sharjeelmazhar/solar-monitor/web/src/assets/earth/day.webp

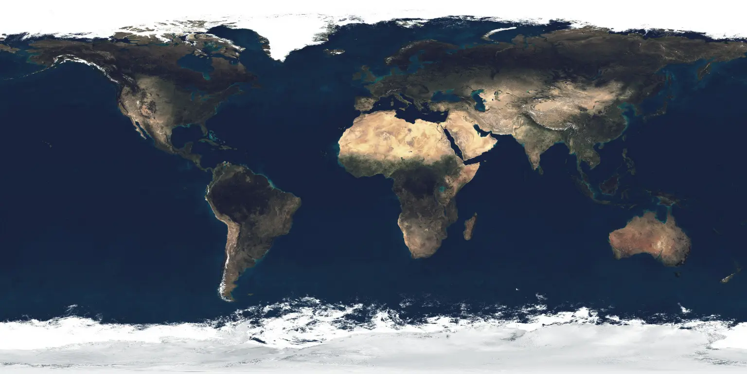
web/src/assets/earth/day.webp
