sharjeelmazhar/solar-monitor/web/src/assets/earth/night.webp

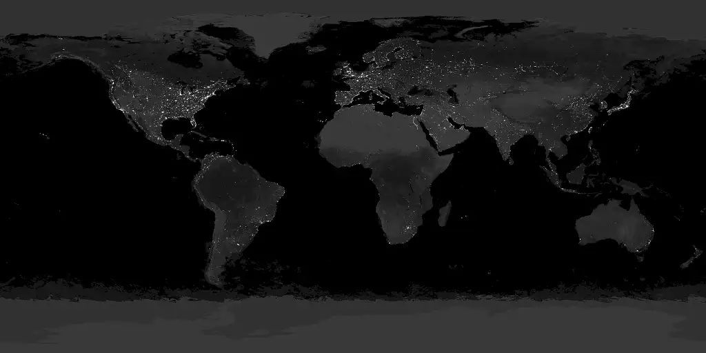
web/src/assets/earth/night.webp
