sharjeelmazhar/solar-monitor/docs/wiring/S3-wiring-page1.png

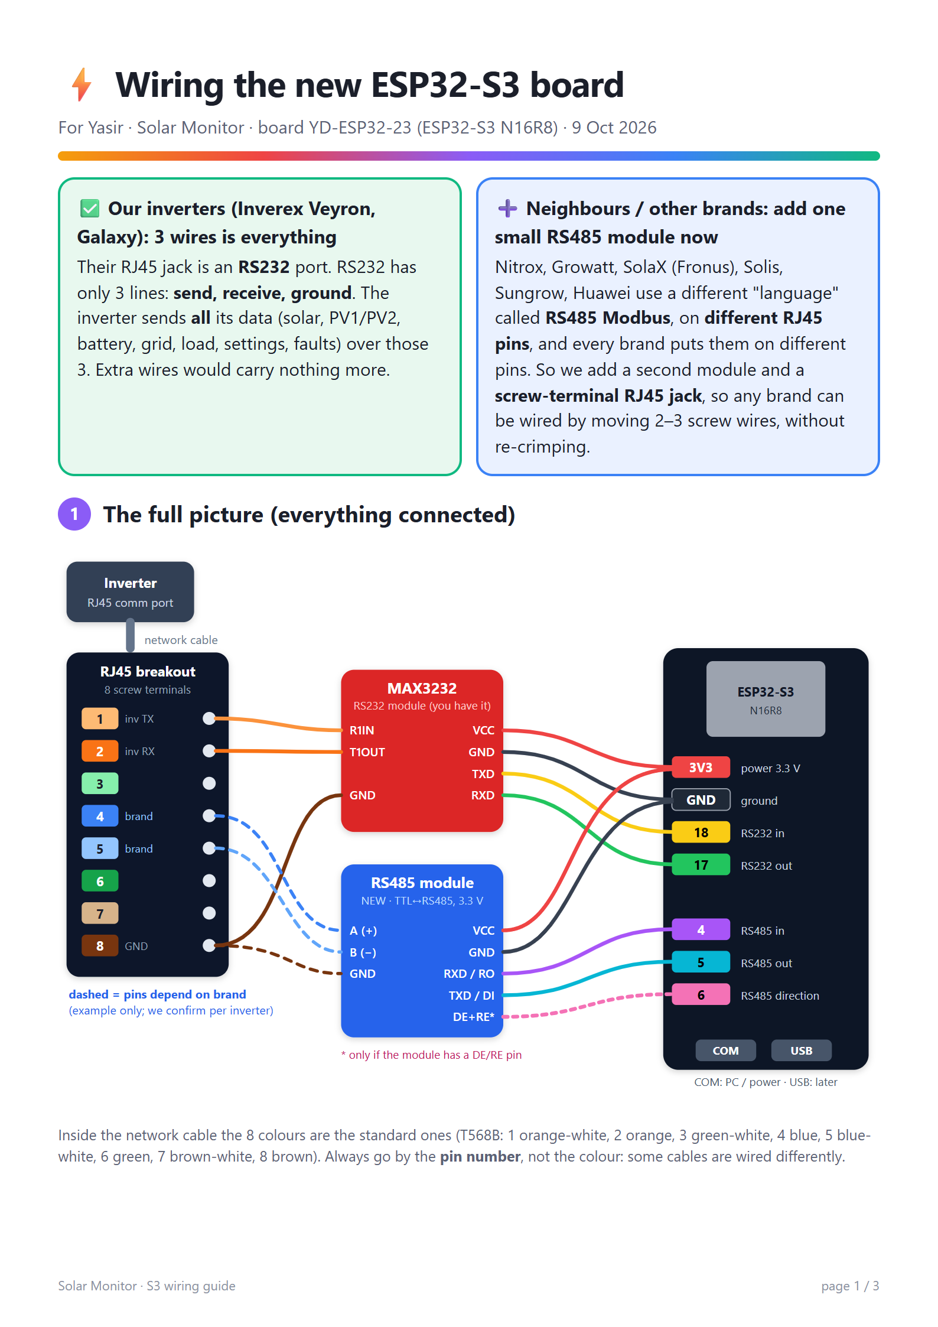
docs/wiring/S3-wiring-page1.png
