sharjeelmazhar/solar-monitor/docs/wiring/S3-wiring-page2.png

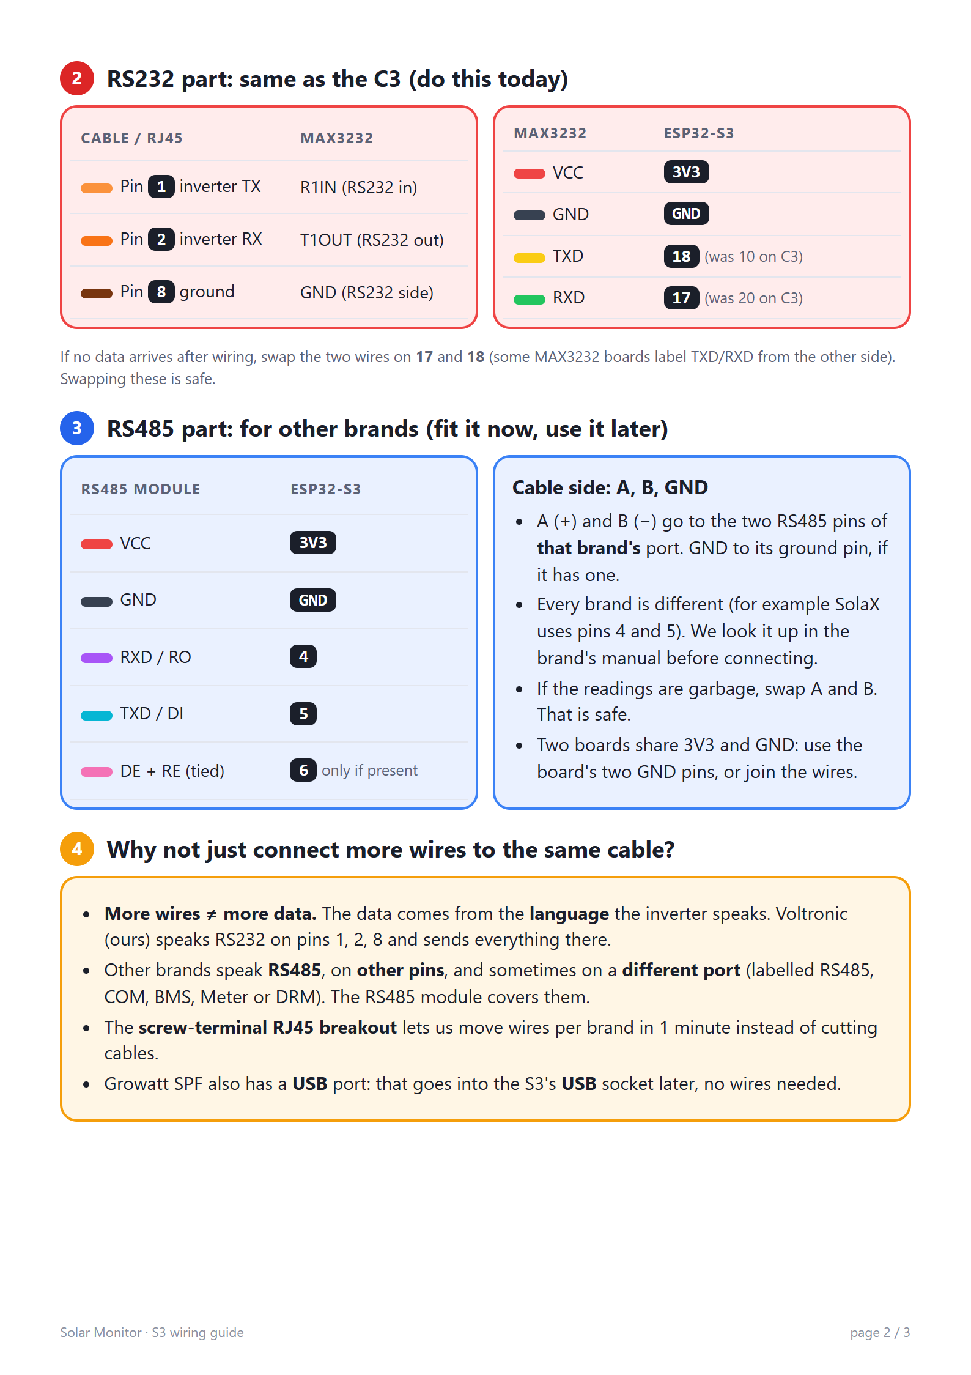
docs/wiring/S3-wiring-page2.png
