sharjeelmazhar/solar-monitor/docs/wiring/S3-wiring-page3.png

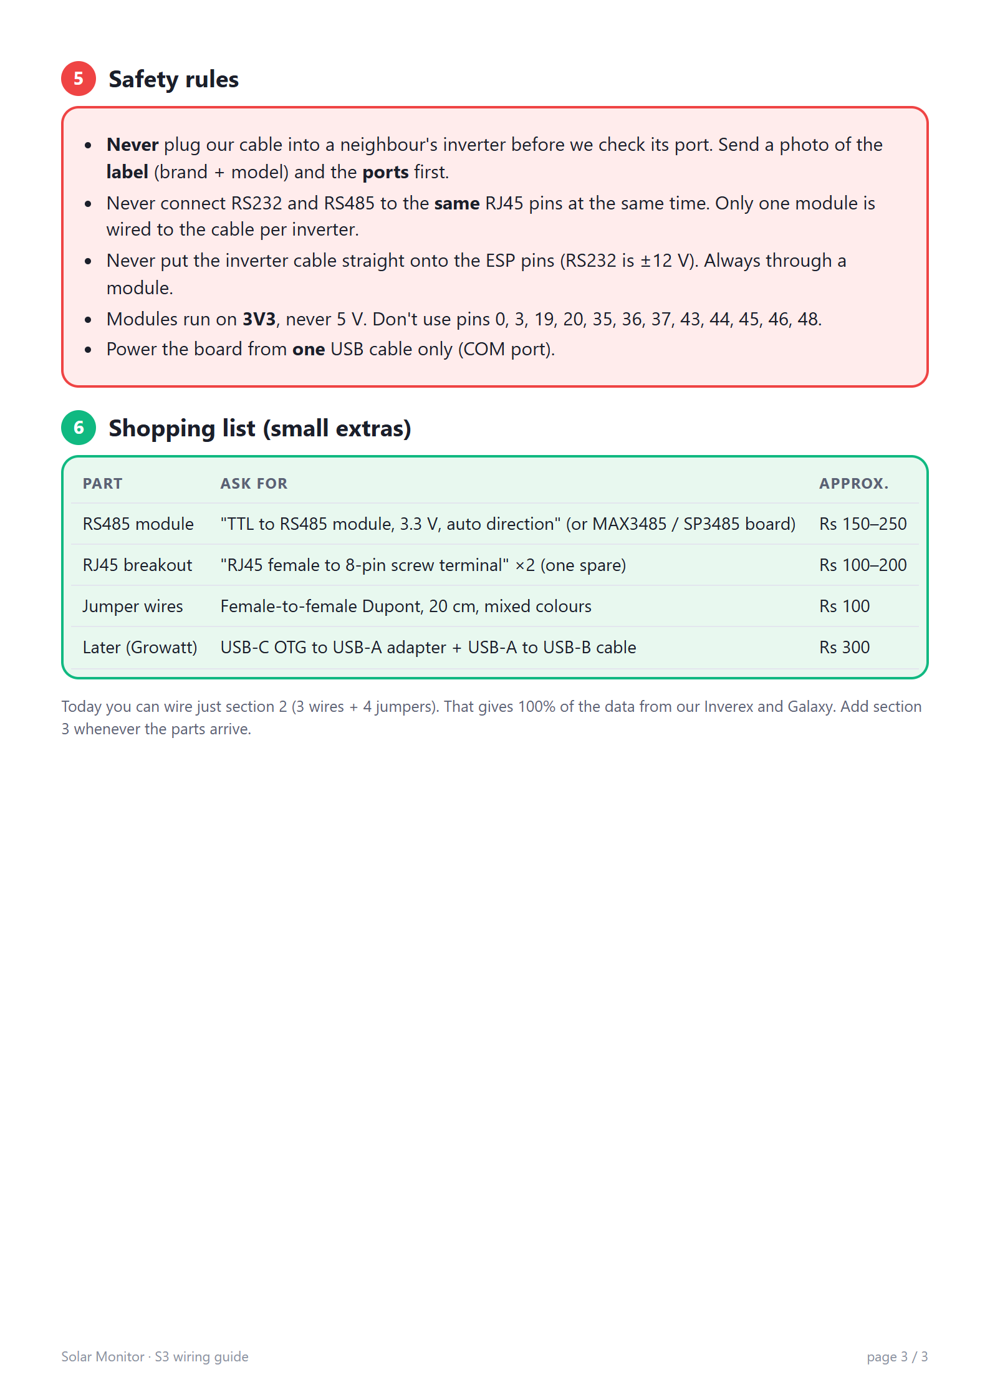
docs/wiring/S3-wiring-page3.png
