sharjeelmazhar/solar-monitor/firmware/solar_monitor_v3/solar_monitor_v3.ino

/*
  Solar Monitor v3 - ESP32-C3 Super Mini + MAX3232 + Inverex Veyron (Voltronic PI30 protocol)

  What it does
    - Reads the inverter as fast as the 2400-baud link allows (~1 reading per 0.7 s)
    - Pushes every change instantly to all open dashboards (Server-Sent Events, /events)
    - Keeps per-minute history on flash (~45 days) and daily energy totals (~2 years)
    - Syncs the clock from the internet (NTP); a dashboard can also set it if there is no internet
    - Serves the dashboard itself: http://<ESP32-IP>/ or http://solar.local/
    - Firmware can be updated over Wi-Fi: http://solar.local/update  (user admin, password in config.h)

  Wiring:
    MAX3232 VCC -> 3V3, GND -> GND, TXD -> GPIO10, RXD -> GPIO20
    MAX3232 RS232 side -> inverter RJ45: pin1 = TX, pin2 = RX, pin8 = GND

  Arduino IDE: Board "ESP32C3 Dev Module", USB CDC On Boot = Enabled,
               Partition Scheme = Default 4MB with spiffs.
  Libraries:   "ESP Async WebServer" and "Async TCP" (both by ESP32Async), from Library Manager.
  The web page lives in web/index.html; run build_web.ps1 to regenerate web_index.h after editing it.

  HTTP API (all JSON unless noted, CORS open so apps can use it)
    GET  /events                 SSE stream, event "live" = same JSON as /api/live, on every change
    GET  /events/status          same, but only on mode/grid/battery%/warning changes + 60 s heartbeat (for phones in background)
    GET  /api/live               latest reading + today's totals
    GET  /api/info               device, Wi-Fi, storage, inverter ratings (raw QPIRI etc.), settings
    GET  /api/recent             binary Sample[] (16 B each), last ~15 min, oldest first
    GET  /api/day?d=YYYYMMDD     binary MinRec[] (24 B each) for that local day
    GET  /api/days               binary DayRec[] (40 B each), oldest first, today (in progress) last
    POST /api/time    t=<epoch seconds>                      set clock if NTP is not available
    POST /api/settings battAh, tariff, name, tz              user settings
    GET/POST /api/bill  v=<json, max 2 KB>                    bill estimator settings (opaque to the firmware)
    POST /api/wifi    ssid, pass          (admin auth)       join another network
    GET  /api/scan                                            nearby Wi-Fi networks
    POST /api/refresh                                         re-read inverter ratings now
    GET/POST /update                      (admin auth)       firmware update
*/

#include <WiFi.h>
#include <ESPmDNS.h>
#include <LittleFS.h>
#include <Preferences.h>
#include <Update.h>
#include <esp_wifi.h>
#include <esp_task_wdt.h>
#include <esp_ota_ops.h>
#include <DNSServer.h>
#include <sys/time.h>
#include <AsyncTCP.h>
#include <ESPAsyncWebServer.h>
#include "config.h"
#include "inverter.h"
#include "invset.h"
#include "history.h"
#include "web_index.h"
#include "setup_page.h"

AsyncWebServer server(80);
DNSServer dns;   // setup hotspot: answers every name with our address so phones open the setup page
AsyncEventSource events("/events");
AsyncEventSource statusEvents("/events/status");   // quiet stream for phone background alerts
Preferences prefs;
SemaphoreHandle_t dataMux;

// ---------- shared state (guarded by dataMux) ----------
Live live;
bool everOk = false;
uint32_t lastOkMs = 0, seq = 0, cycleMs = 0, okCount = 0, failCount = 0;
char liveJson[1600] = "{\"ok\":false,\"ever\":false}";

Sample ring[RECENT_SAMPLES];
int ringHead = 0, ringCount = 0;   // head = next write position

MinRec todayRecs[1440];
int todayCount = 0;

DayRec today;            // running totals for the current local day
bool todayLoaded = false;
uint32_t histFrom = 0;   // oldest day with minute data

// inverter info, refreshed rarely
char qpiri[160] = "", qid[40] = "", qvfw[40] = "", qflag[40] = "";
char chgCur[64] = "", acCur[64] = "";   // allowed max charge currents (QMCHGCR / QMUCHGCR)
char qbeqi[64] = "";                    // battery equalization settings (QBEQI)

// a settings change waiting for the loop task: state 0 none, 1 waiting, 2 done ok, 3 failed
struct SetJob {
  uint32_t id = 0;
  uint8_t state = 0;
  char key[16] = "";
  float value = 0;
  char letter = 0;
  char by[40] = "";
  char msg[96] = "";
} setJob;
uint8_t probeState = 0;   // 0 never, 1 waiting, 2 done
String probeText;

// settings
float setBattAh = 0, setTariff = 0;
String setName = "Solar", setTz = TZ_DEFAULT;
String setBill;   // bill estimator settings: JSON written by the apps, stored as-is

// Billing month counter: energy since the last meter reading (reading day + hour, sent by the apps from the bill
// settings). Kept in NVS so a restart doesn't lose it; at most 15 minutes of counting are lost on a power cut.
int setCycDay = 0, setCycHour = 20;   // day 0 = not set yet
struct Cycle {
  uint32_t start = 0;      // epoch of the meter reading this month started at
  uint32_t from = 0;       // when counting began (later than start if the monitor was off or set up mid-month)
  float gridWh = 0, loadWh = 0, pvWh = 0;
  uint32_t onMin = 0;      // minutes the monitor was reading the inverter this month
  uint32_t prevStart = 0;  // the month before (so the apps can show the last bill's measured units)
  float prevGridWh = 0;
  uint32_t prevOnMin = 0;
} cyc;
uint32_t cycSavedMs = 0;
volatile bool cycMoved = false;   // reading day/hour changed in the settings

// misc
bool fsOk = false, mdnsOk = false, apOn = false, rebootPending = false, refreshRated = true;
bool timeSetByClient = false;
uint32_t wifiLostAt = 0, rebootAt = 0, staUpAt = 0, joinAt = 0;
char apName[24] = SETUP_AP_SSID;

// ---------- minute accumulator (loop task only) ----------
struct {
  uint32_t minute = 0;   // epoch / 60
  uint32_t n = 0;
  double pv = 0, load = 0, grid = 0, batt = 0, battV = 0, pvV = 0, gridV = 0, outV = 0;
  uint8_t battPct = 0, mode = '?', flags = 0;
  int8_t tempMax = -128;
} acc;

static void ledSet(bool on) {
  if (LED_PIN >= 0) digitalWrite(LED_PIN, on ? LED_ON : !LED_ON);
}

// A new firmware starts "on trial": if it can't get back on Wi-Fi within 5 minutes the board restarts and
// the bootloader goes back to the previous firmware by itself. Once it is on Wi-Fi it is kept.
extern "C" bool verifyRollbackLater() { return true; }
static void serviceTrial() {
  static bool done = false;
  if (done) return;
  const esp_partition_t* run = esp_ota_get_running_partition();
  esp_ota_img_states_t st;
  if (esp_ota_get_state_partition(run, &st) != ESP_OK || st != ESP_OTA_IMG_PENDING_VERIFY) { done = true; return; }
  if (WiFi.status() == WL_CONNECTED && millis() > 20000) {
    esp_ota_mark_app_valid_cancel_rollback();
    Serial.println("Firmware confirmed");
    done = true;
  } else if (millis() > 300000) {
    Serial.println("New firmware never reached Wi-Fi: going back to the previous one");
    esp_ota_mark_app_invalid_rollback_and_reboot();
  }
}

static bool timeValid() { return time(nullptr) > 1735689600; }   // after 2025-01-01

static inline void lock()   { xSemaphoreTake(dataMux, portMAX_DELAY); }
static inline void unlock() { xSemaphoreGive(dataMux); }

// only safe characters reach the JSON
static void jsonSafe(char* dst, const char* src, size_t cap) {
  size_t j = 0;
  for (size_t i = 0; src[i] && j < cap - 1; i++) {
    char c = src[i];
    if (c >= 32 && c < 127 && c != '"' && c != '\\') dst[j++] = c;
  }
  dst[j] = 0;
}

static uint8_t liveFlags(const Live& L) {
  uint8_t f = 0;
  if (L.gridOn) f |= 1;
  if (strlen(L.st) == 8) {
    if (L.st[6] == '1') f |= 2;   // b1 SCC (solar) charging
    if (L.st[7] == '1') f |= 4;   // b0 AC (grid) charging
    if (L.st[3] == '1') f |= 8;   // b4 load on
  }
  return f;
}

// ---------- JSON ----------
static void buildLiveJsonLocked() {
  const Live& L = live;
  struct timeval tv;
  gettimeofday(&tv, nullptr);
  double tms = timeValid() ? (double)tv.tv_sec * 1000.0 + tv.tv_usec / 1000 : 0;
  bool fresh = everOk && millis() - lastOkMs < STALE_MS;
  char err[64];
  jsonSafe(err, invErr, sizeof(err));
  char mode[2] = {L.mode ? L.mode : '?', 0};
  snprintf(liveJson, sizeof(liveJson),
    "{\"seq\":%lu,\"t\":%.0f,\"ok\":%s,\"ever\":%s,\"age\":%lu,\"mode\":\"%s\","
    "\"pvW\":%d,\"pvV\":%.1f,\"pvA\":%.1f,\"pv2V\":%.1f,\"pv2A\":%.1f,\"pvChgW\":%d,"
    "\"battV\":%.2f,\"battVscc\":%.2f,\"battPct\":%d,\"chgA\":%.1f,\"dischgA\":%.1f,\"battW\":%d,"
    "\"loadW\":%d,\"loadVA\":%d,\"loadPct\":%d,\"outV\":%.1f,\"outHz\":%.1f,"
    "\"gridOn\":%s,\"gridV\":%.1f,\"gridHz\":%.1f,\"gridW\":%d,"
    "\"tempC\":%d,\"busV\":%d,\"st\":\"%s\",\"st2\":\"%s\",\"warn\":\"%s\","
    "\"today\":{\"date\":%lu,\"pv\":%.1f,\"load\":%.1f,\"grid\":%.1f,\"chg\":%.1f,\"dis\":%.1f,"
    "\"gridOnMin\":%u,\"onlineMin\":%u,\"outages\":%u,\"pvPeak\":%u,\"loadPeak\":%u},"
    "\"poll\":{\"ms\":%lu,\"ok\":%lu,\"fail\":%lu,\"crc\":%lu,\"err\":\"%s\"},\"timeOk\":%s,"
    "\"cyc\":{\"s\":%lu,\"f\":%lu,\"g\":%.1f,\"l\":%.1f,\"p\":%.1f,\"m\":%lu,\"ps\":%lu,\"pg\":%.1f,\"pm\":%lu}}",
    (unsigned long)seq, tms, fresh ? "true" : "false", everOk ? "true" : "false",
    everOk ? (unsigned long)(millis() - lastOkMs) : 0UL, mode,
    L.pvW, L.pvV, L.pvA, L.pv2V, L.pv2A, L.pvChgW,
    L.battV, L.battVscc, L.battPct, L.chgA, L.dischgA, L.battW,
    L.outW, L.outVA, L.loadPct, L.outV, L.outHz,
    L.gridOn ? "true" : "false", L.gridV, L.gridHz, L.gridW,
    L.tempC, L.busV, L.st, L.st2, L.warn,
    (unsigned long)today.date, today.pvWh, today.loadWh, today.gridWh, today.chgWh, today.disWh,
    today.gridOnMin, today.onlineMin, today.outages, today.pvPeakW, today.loadPeakW,
    (unsigned long)cycleMs, (unsigned long)okCount, (unsigned long)failCount, (unsigned long)invCrcErrors, err,
    timeValid() ? "true" : "false",
    (unsigned long)cyc.start, (unsigned long)cyc.from, cyc.gridWh, cyc.loadWh, cyc.pvWh, (unsigned long)cyc.onMin,
    (unsigned long)cyc.prevStart, cyc.prevGridWh, (unsigned long)cyc.prevOnMin);
}

static String buildInfoJson() {
  char a[160], b[40], c[40], d[40], name[40], tz[40], ssid[40], m1[64], m2[64], eq[64];
  lock();
  jsonSafe(a, qpiri, sizeof(a)); jsonSafe(b, qid, sizeof(b));
  jsonSafe(c, qvfw, sizeof(c));  jsonSafe(d, qflag, sizeof(d));
  jsonSafe(m1, chgCur, sizeof(m1)); jsonSafe(m2, acCur, sizeof(m2)); jsonSafe(eq, qbeqi, sizeof(eq));
  jsonSafe(name, setName.c_str(), sizeof(name)); jsonSafe(tz, setTz.c_str(), sizeof(tz));
  uint32_t from = histFrom;
  unlock();
  jsonSafe(ssid, WiFi.SSID().c_str(), sizeof(ssid));
  char buf[1400];
  snprintf(buf, sizeof(buf),
    "{\"fw\":\"%s\",\"board\":\"" FW_BOARD "\",\"histVer\":%d,\"name\":\"%s\",\"host\":\"%s\",\"ip\":\"%s\",\"mac\":\"%s\",\"ssid\":\"%s\",\"rssi\":%d,"
    "\"ap\":%s,\"uptime\":%lu,\"heap\":%lu,\"minHeap\":%lu,\"fsUsed\":%lu,\"fsTotal\":%lu,\"fsOk\":%s,"
    "\"timeOk\":%s,\"time\":%lu,\"tz\":\"%s\",\"clients\":%u,\"histFrom\":%lu,"
    "\"battAh\":%.1f,\"tariff\":%.2f,\"cycDay\":%d,\"cycHour\":%d,\"reset\":%d,"
    "\"inv\":{\"proto\":\"%s\",\"qpiri\":\"%s\",\"qid\":\"%s\",\"qvfw\":\"%s\",\"qflag\":\"%s\",\"chgCur\":\"%s\",\"acCur\":\"%s\",\"beqi\":\"%s\"}}",
    FW_VERSION, HIST_VERSION, name, HOSTNAME, WiFi.localIP().toString().c_str(), WiFi.macAddress().c_str(), ssid,
    WiFi.RSSI(), apOn ? "true" : "false", (unsigned long)(millis() / 1000), (unsigned long)ESP.getFreeHeap(),
    (unsigned long)ESP.getMinFreeHeap(), fsOk ? (unsigned long)LittleFS.usedBytes() : 0UL,
    fsOk ? (unsigned long)LittleFS.totalBytes() : 0UL, fsOk ? "true" : "false",
    timeValid() ? "true" : "false", (unsigned long)time(nullptr), tz, (unsigned)events.count(), (unsigned long)from,
    setBattAh, setTariff, setCycDay, setCycHour, (int)esp_reset_reason(), protoName(invProto), a, b, c, d, m1, m2, eq);
  return String(buf);
}

// ---------- history ----------
static void finalizeMinute() {
  if (acc.n == 0 || !fsOk) { acc.n = 0; return; }
  MinRec m;
  m.t = acc.minute * 60;
  m.pvW = (uint16_t)lround(acc.pv / acc.n);
  m.loadW = (uint16_t)lround(acc.load / acc.n);
  m.gridW = (uint16_t)lround(acc.grid / acc.n);
  m.battW = (int16_t)lround(acc.batt / acc.n);
  m.battV = (uint16_t)lround(acc.battV / acc.n * 100);
  m.pvV = (uint16_t)lround(acc.pvV / acc.n * 10);
  m.gridV = (uint16_t)lround(acc.gridV / acc.n * 10);
  m.outV = (uint16_t)lround(acc.outV / acc.n * 10);
  m.battPct = acc.battPct;
  m.tempC = acc.tempMax;
  m.mode = acc.mode;
  m.flags = acc.flags;
  acc.n = 0;
  acc.pv = acc.load = acc.grid = acc.batt = acc.battV = acc.pvV = acc.gridV = acc.outV = 0;
  acc.tempMax = -128;

  uint32_t date = localDate(m.t);
  if (date != today.date) return;   // belongs to a day we already closed
  lock();
  bool dup = todayCount > 0 && todayRecs[todayCount - 1].t >= m.t;
  if (!dup && cyc.start && m.t >= cyc.start) cyc.onMin++;
  if (!dup && todayCount < 1440) {
    todayRecs[todayCount++] = m;
    today.onlineMin++;
    if (m.flags & 1) today.gridOnMin++;
  }
  unlock();
  if (dup) return;
  if (!LittleFS.exists("/h")) LittleFS.mkdir("/h");
  File f = LittleFS.open(dayPath(date), "a");
  if (f) { f.write((const uint8_t*)&m, sizeof(m)); f.close(); }
}

// Called once the clock is valid: restore today's minutes and totals from flash.
static void loadToday() {
  uint32_t date = localDate(time(nullptr));
  DayRec d;
  dayInit(d, date);
  int cnt = 0;
  if (fsOk) reconcileAndPrune(date);
  lock();
  if (fsOk) {
    File f = LittleFS.open(dayPath(date), "r");
    if (f) {
      bool pk = false, pg = false;
      MinRec m;
      while (cnt < 1440 && f.read((uint8_t*)&m, sizeof(m)) == sizeof(m)) {
        if (cnt && m.t <= todayRecs[cnt - 1].t) continue;
        todayRecs[cnt++] = m;
        dayAddMinute(d, m, pk, pg);
      }
      f.close();
    }
  }
  if (cnt == 0) d.battMin = 255;
  todayCount = cnt;
  // keep energy counted before the clock was set
  d.pvWh += today.pvWh; d.loadWh += today.loadWh; d.gridWh += today.gridWh;
  d.chgWh += today.chgWh; d.disWh += today.disWh;
  today = d;
  histFrom = fsOk ? oldestDayFile() : 0;
  todayLoaded = true;
  unlock();
  Serial.printf("History: today %lu, %d minutes restored, history from %lu\n", (unsigned long)date, cnt, (unsigned long)histFrom);
}

static void rollDay(uint32_t newDate) {
  finalizeMinute();
  DayRec done;
  lock();
  done = today;
  if (done.onlineMin == 0 && done.battMin == 255) done.battMin = 0;
  dayInit(today, newDate);
  todayCount = 0;
  unlock();
  if (fsOk) {
    appendDay(done);
    reconcileAndPrune(newDate);
    uint32_t from = oldestDayFile();
    lock(); histFrom = from; unlock();
  }
  Serial.printf("New day %lu\n", (unsigned long)newDate);
}

// ---------- billing month ----------
// The last meter reading at or before `now`: day setCycDay of this month (or the month before) at setCycHour, local time.
static time_t cycleStartFor(time_t now) {
  struct tm t;
  localtime_r(&now, &t);
  for (int back = 0; back < 2; back++) {
    struct tm c = t;
    c.tm_mon -= back;
    c.tm_mday = setCycDay; c.tm_hour = setCycHour; c.tm_min = 0; c.tm_sec = 0; c.tm_isdst = -1;
    time_t s = mktime(&c);
    if (s <= now) return s;
  }
  return 0;
}

static void saveCycle() {
  Cycle c;
  lock(); c = cyc; unlock();
  prefs.putBytes("cyc", &c, sizeof(c));
  cycSavedMs = millis();
}

static void serviceCycle(time_t now) {
  time_t s = cycleStartFor(now);
  if (cycMoved) {
    cycMoved = false;
    // the energy counted so far still fits the new month if counting began after its start
    lock();
    if (cyc.start && cyc.from >= (uint32_t)s) cyc.start = s; else cyc.start = 0;
    unlock();
    if (cyc.start) { saveCycle(); return; }
  }
  if (!s || cyc.start == (uint32_t)s) return;
  lock();
  bool rolled = cyc.start && (uint32_t)s > cyc.start;
  if (rolled) { cyc.prevStart = cyc.start; cyc.prevGridWh = cyc.gridWh; cyc.prevOnMin = cyc.onMin; }
  // counting from the reading itself if the monitor was running then, else from now
  bool continuous = rolled && now - s < 120;
  cyc.start = s;
  cyc.from = continuous ? s : now;
  cyc.gridWh = cyc.loadWh = cyc.pvWh = 0;
  cyc.onMin = 0;
  unlock();
  saveCycle();
  Serial.printf("Billing month from %lu (counting from %lu)\n", (unsigned long)cyc.start, (unsigned long)cyc.from);
}

// ---------- one good reading ----------
static uint32_t lastSampleMs = 0;
static bool prevGridKnown = false, prevGrid = false;

static void commitSample(const Live& L) {
  uint32_t nowMs = millis();
  float dtH = 0;
  if (lastSampleMs) dtH = min<uint32_t>(nowMs - lastSampleMs, 5000) / 3600000.0f;
  lastSampleMs = nowMs;

  time_t now = time(nullptr);
  bool tOk = timeValid();
  if (tOk && !todayLoaded) loadToday();
  if (tOk) {
    uint32_t date = localDate(now);
    if (date != today.date && todayLoaded) rollDay(date);
  }

  if (tOk && setCycDay) serviceCycle(now);

  struct timeval tv;
  gettimeofday(&tv, nullptr);
  Sample s;
  s.t = tOk ? (uint32_t)tv.tv_sec : 0;
  s.ms = tOk ? tv.tv_usec / 1000 : 0;
  s.pvW = L.pvW; s.loadW = L.outW; s.gridW = L.gridW; s.battW = L.battW;
  s.battPct = L.battPct; s.flags = liveFlags(L);

  lock();
  live = L;
  everOk = true;
  lastOkMs = nowMs;
  okCount++;
  seq++;
  ring[ringHead] = s;
  ringHead = (ringHead + 1) % RECENT_SAMPLES;
  if (ringCount < RECENT_SAMPLES) ringCount++;
  // energy
  today.pvWh += L.pvW * dtH;
  today.loadWh += L.outW * dtH;
  today.gridWh += L.gridW * dtH;
  if (L.battW > 0) today.chgWh += L.battW * dtH; else today.disWh += -L.battW * dtH;
  if (L.pvW > today.pvPeakW) today.pvPeakW = L.pvW;
  if (L.outW > today.loadPeakW) today.loadPeakW = L.outW;
  if (cyc.start) {
    cyc.gridWh += L.gridW * dtH;
    cyc.loadWh += L.outW * dtH;
    cyc.pvWh += L.pvW * dtH;
  }
  if (L.battPct < today.battMin) today.battMin = L.battPct;
  if (L.battPct > today.battMax) today.battMax = L.battPct;
  if (L.tempC > today.tempMax) today.tempMax = L.tempC;
  if (prevGridKnown && prevGrid && !L.gridOn && today.outages < 255) today.outages++;
  prevGrid = L.gridOn; prevGridKnown = true;
  buildLiveJsonLocked();
  unlock();

  // per-minute averages
  if (tOk && todayLoaded) {
    uint32_t minute = now / 60;
    if (acc.minute != minute) {
      if (acc.minute && minute > acc.minute) finalizeMinute();
      acc.n = 0;
      acc.pv = acc.load = acc.grid = acc.batt = acc.battV = acc.pvV = acc.gridV = acc.outV = 0;
      acc.tempMax = -128;
      acc.minute = minute;
    }
    acc.n++;
    acc.pv += L.pvW; acc.load += L.outW; acc.grid += L.gridW; acc.batt += L.battW;
    acc.battV += L.battV; acc.pvV += L.pvV; acc.gridV += L.gridV; acc.outV += L.outV;
    acc.battPct = L.battPct; acc.mode = L.mode; acc.flags = liveFlags(L);
    if (L.tempC > acc.tempMax) acc.tempMax = L.tempC;
  }
}

// ---------- inverter polling ----------
static uint32_t cycleNo = 0;
static uint32_t lastPushMs = 0;
static uint32_t lastPushHash = 0;

static uint32_t fnv(const char* s, uint32_t h = 2166136261u) {
  while (*s) { h ^= (uint8_t)*s++; h *= 16777619u; }
  return h;
}

// Ratings and settings (PI30). Also the allowed charge currents, so settings changes can be checked.
static bool readRated() {
  char r[160], a[40], b[40], c[40], m1[64], m2[64], eq[64];
  bool got = invQuery("QPIRI", r, sizeof(r)) > 0;
  bool gotId = invQuery("QID", a, sizeof(a), 800) > 0;
  bool gotFw = invQuery("QVFW", b, sizeof(b), 800) > 0;
  bool gotFl = invQuery("QFLAG", c, sizeof(c), 800) > 0;
  bool gotM1 = invQuery("QMCHGCR", m1, sizeof(m1), 800) > 0;
  bool gotM2 = invQuery("QMUCHGCR", m2, sizeof(m2), 800) > 0;
  bool gotEq = invQuery("QBEQI", eq, sizeof(eq), 800) > 0;
  lock();
  if (got) strlcpy(qpiri, r, sizeof(qpiri));
  if (gotId) strlcpy(qid, a, sizeof(qid));
  if (gotFw) strlcpy(qvfw, b, sizeof(qvfw));
  if (gotFl) strlcpy(qflag, c, sizeof(qflag));
  if (gotM1) strlcpy(chgCur, m1, sizeof(chgCur));
  if (gotM2) strlcpy(acCur, m2, sizeof(acCur));
  if (gotEq) strlcpy(qbeqi, eq, sizeof(qbeqi));
  unlock();
  return got;
}

// ---------- changing a setting (runs in the loop task, which owns the serial link) ----------
static void appendSetLog(const char* line) {
  if (!fsOk) return;
  File f = LittleFS.open("/setlog.txt", "r");
  if (f && f.size() > 6000) {   // keep the newest half
    String all = f.readString();
    f.close();
    int cut = all.indexOf('\n', all.length() / 2);
    File w = LittleFS.open("/setlog.txt", "w");
    if (w) { w.print(all.substring(cut + 1)); w.close(); }
  } else if (f) f.close();
  File a = LittleFS.open("/setlog.txt", "a");
  if (a) { a.println(line); a.close(); }
}

static void runSetJob() {
  SetJob j;
  lock(); j = setJob; unlock();
  char cmd[24], err[64], q[160], cl[64], al[64], fl[40], eq[64];
  lock(); strlcpy(q, qpiri, sizeof q); strlcpy(cl, chgCur, sizeof cl); strlcpy(al, acCur, sizeof al); strlcpy(fl, qflag, sizeof fl); strlcpy(eq, qbeqi, sizeof eq); unlock();
  const char* state = "failed";
  char msg[96] = "";
  char oldV[16] = "";
  int field = setKeyField(j.key);
  if (field >= EQ_BASE) { float o = qpiriField(eq, field - EQ_BASE); snprintf(oldV, sizeof oldV, "%g", o); }
  else if (field >= 0) { float o = qpiriField(q, field); snprintf(oldV, sizeof oldV, "%g", o); }
  else if (field == KEY_FLAG) { const char* d = strchr(fl, 'D'); const char* l = strchr(fl, j.letter); snprintf(oldV, sizeof oldV, "%s", !d || !l ? "?" : l < d ? "on" : "off"); }
  if (invProto != PROTO_PI30) {
    snprintf(msg, sizeof msg, "changing settings is only supported on PI30 inverters");
  } else if (!buildSetCommand(j.key, j.value, j.letter, q, cl, al, cmd, sizeof cmd, err, sizeof err)) {
    snprintf(msg, sizeof msg, "not sent: %s", err);
  } else {
    char rep[16];
    int r = invQuery(cmd, rep, sizeof rep, 3000);
    if (r <= 0) snprintf(msg, sizeof msg, "inverter refused (%s)", invErr);
    else if (strncmp(rep, "ACK", 3) != 0) snprintf(msg, sizeof msg, "inverter answered %s", rep);
    else {
      delay(300);
      readRated();
      lock(); strlcpy(q, qpiri, sizeof q); strlcpy(fl, qflag, sizeof fl); strlcpy(eq, qbeqi, sizeof eq); unlock();
      if (setVerified(j.key, j.value, j.letter, q, fl, eq)) { state = "ok"; snprintf(msg, sizeof msg, "saved and read back"); }
      else snprintf(msg, sizeof msg, "inverter said OK but still shows the old value");
    }
  }
  char newV[16];
  if (field == KEY_FLAG) snprintf(newV, sizeof newV, "%s", j.value == 1 ? "on" : "off");
  else if (field == KEY_RESTORE) snprintf(newV, sizeof newV, "defaults");
  else snprintf(newV, sizeof newV, "%g", j.value);
  char key[16];
  if (field == KEY_FLAG) snprintf(key, sizeof key, "flag:%c", j.letter); else snprintf(key, sizeof key, "%s", j.key);
  char line[260];
  snprintf(line, sizeof line, "{\"t\":%lu,\"by\":\"%s\",\"k\":\"%s\",\"o\":\"%s\",\"n\":\"%s\",\"r\":\"%s\",\"m\":\"%s\"}",
           (unsigned long)time(nullptr), j.by, key, oldV, newV, state, msg);
  appendSetLog(line);
  Serial.printf("Setting: %s\n", line);
  lock();
  setJob.state = strcmp(state, "ok") == 0 ? 2 : 3;
  strlcpy(setJob.msg, msg, sizeof setJob.msg);
  unlock();
}

// ---------- probe: read-only questions in every protocol we know, to learn how an unknown inverter talks ----------
static void probeAppend(String& out, const char* label, const char* data, int n) {
  out += label; out += ": ";
  if (n < 0) { out += n == -1 ? "(no answer)\n" : "(cut off)\n"; return; }
  for (int i = 0; i < n; i++) {
    uint8_t c = (uint8_t)data[i];
    if (c >= 32 && c < 127 && c != '\\') out += (char)c; else { char h[6]; snprintf(h, sizeof h, "\\x%02X", c); out += h; }
  }
  out += "\n";
}

static void runProbe() {
  String out;
  out.reserve(3000);
  out += "Probe at "; out += (unsigned long)time(nullptr); out += ", current protocol "; out += protoName(invProto); out += "\n\n# PI30 (2400 baud)\n";
  char buf[260];
  static const char* pi30[] = {"QPI", "QID", "QVFW", "QVFW2", "QMN", "QGMN", "QPIRI", "QPIGS", "QPIGS2", "QMOD", "QPIWS", "QFLAG", "QMCHGCR", "QMUCHGCR", "QBEQI"};
  for (const char* c : pi30) {
    uint8_t fr[24]; size_t fl = buildRequest(c, fr, sizeof fr);
    int n = invExchange(fr, fl, buf, sizeof buf, 1200, '(');
    probeAppend(out, c, buf, n);
    esp_task_wdt_reset();
  }
  out += "\n# PI18 (2400 baud)\n";
  static const char* pi18[] = {"PI", "ID", "VFW", "MD", "PIRI", "GS", "MOD", "FWS", "FLAG"};
  for (const char* c : pi18) {
    char cmd[16]; pi18Command(c, cmd, sizeof cmd);
    uint8_t fr[24]; size_t fl = buildRequest(cmd, fr, sizeof fr);
    int n = invExchange(fr, fl, buf, sizeof buf, 1200, '^');
    probeAppend(out, cmd, buf, n);
    esp_task_wdt_reset();
  }
  // Modbus RTU: function 03/04 reads only (cannot change anything). Common register blocks of other brands.
  struct { uint32_t baud; uint8_t fn; uint16_t reg; } mb[] = {
    {9600, 3, 0x0100}, {9600, 3, 0x0200}, {9600, 3, 0x0000}, {9600, 4, 0x0000}, {19200, 3, 0x0000}, {2400, 3, 0x0000},
  };
  out += "\n# Modbus RTU, slave 1, 10 registers (hex)\n";
  for (auto& m : mb) {
    Serial1.updateBaudRate(m.baud);
    delay(50);
    uint8_t fr[8]; modbusRead(1, m.fn, m.reg, 10, fr);
    int n = invExchange(fr, 8, buf, sizeof buf, 600, 0);
    char label[40]; snprintf(label, sizeof label, "%lu fn%u reg 0x%04X", (unsigned long)m.baud, m.fn, m.reg);
    out += label; out += ": ";
    if (n <= 0) out += "(no answer)";
    for (int i = 0; i < n; i++) { char h[4]; snprintf(h, sizeof h, "%02X ", (uint8_t)buf[i]); out += h; }
    out += "\n";
    esp_task_wdt_reset();
  }
  Serial1.updateBaudRate(2400);
  delay(50);
  lock(); probeText = out; probeState = 2; unlock();
}

static uint32_t failRun = 0;

static void pollInverter() {
  uint32_t t0 = millis();
  Live L;
  lock(); L = live; unlock();

  if (setJob.state == 1) runSetJob();
  if (probeState == 1) { runProbe(); invProto = PROTO_NONE; }
  if (invProto == PROTO_NONE) {
    static Proto lastProto = PROTO_NONE;
    invProto = invDetect();
    if (invProto != PROTO_NONE) {
      Serial.printf("Inverter speaks %s\n", protoName(invProto));
      refreshRated = true;
      if (invProto != lastProto) {   // another inverter: forget the old one's settings
        lock(); qpiri[0] = qid[0] = qvfw[0] = qflag[0] = chgCur[0] = acCur[0] = qbeqi[0] = 0; unlock();
        lastProto = invProto;
      }
    }
  }

  uint32_t h = 0;
  bool ok = invProto != PROTO_NONE && invReadLive(L, cycleNo % 5 == 0, h, fnv);
  if (ok) {
    failRun = 0;
    estimateGrid(L);
    h = fnv(L.warn, (h ^ (uint8_t)L.mode) * 16777619u);
    if (refreshRated) refreshRated = invProto == PROTO_PI30 ? !readRated() : false;   // retry next cycle if QPIRI failed
    commitSample(L);
  } else {
    if (invProto != PROTO_NONE && ++failRun >= 10) { invProto = PROTO_NONE; failRun = 0; }   // moved to another inverter?
    lock();
    failCount++;
    buildLiveJsonLocked();
    unlock();
    Serial.printf("Inverter: %s\n", invErr);
  }
  cycleNo++;
  if (cycleNo % 900 == 0) refreshRated = true;   // ratings/settings every ~10 min

  // push to dashboards: on every change, plus a heartbeat
  uint32_t now = millis();
  if (events.count() > 0 && ((ok && h != lastPushHash) || now - lastPushMs >= HEARTBEAT_MS || !ok)) {
    static char out[sizeof(liveJson)];
    lock(); strlcpy(out, liveJson, sizeof(out)); uint32_t id = seq; unlock();
    events.send(out, "live", id);
    lastPushMs = now;
    lastPushHash = h;
  }

  // quiet stream: only when something an alert could care about changes, plus a 60 s heartbeat
  static uint32_t lastStatusMs = 0, lastStatusSig = 0;
  if (statusEvents.count() > 0) {
    Live c;
    lock(); c = live; bool fresh = everOk && millis() - lastOkMs < STALE_MS; unlock();
    char sig[64];
    snprintf(sig, sizeof(sig), "%d%c%d%d%d%s", fresh, c.mode, c.gridOn, c.battPct, c.battW > 60 ? 1 : c.battW < -60 ? 2 : 0, c.warn);
    uint32_t s = fnv(sig);
    if (s != lastStatusSig || now - lastStatusMs >= 60000) {
      static char out[sizeof(liveJson)];
      lock(); strlcpy(out, liveJson, sizeof(out)); uint32_t id = seq; unlock();
      statusEvents.send(out, "live", id);
      lastStatusSig = s;
      lastStatusMs = now;
    }
  }

  lock(); cycleMs = millis() - t0; unlock();
  ledSet(everOk && millis() - lastOkMs < STALE_MS);
}

// ---------- Wi-Fi ----------
static void startAP() {
  if (apOn) return;
  uint8_t mac[6];
  WiFi.macAddress(mac);
  snprintf(apName, sizeof(apName), "%s-%02X%02X", SETUP_AP_SSID, mac[4], mac[5]);   // e.g. SolarMonitor-7E90
  WiFi.mode(WIFI_AP_STA);
  WiFi.softAP(apName, strlen(SETUP_AP_PASS) >= 8 ? SETUP_AP_PASS : nullptr);
  dns.setErrorReplyCode(DNSReplyCode::NoError);
  dns.start(53, "*", WiFi.softAPIP());
  apOn = true;
  Serial.printf("Setup hotspot '%s' on: http://%s/\n", apName, WiFi.softAPIP().toString().c_str());
}

static void stopAP() {
  if (!apOn) return;
  dns.stop();
  WiFi.softAPdisconnect(true);
  WiFi.mode(WIFI_STA);
  apOn = false;
}

static void onWiFiEvent(WiFiEvent_t e, WiFiEventInfo_t info) {
  if (e == ARDUINO_EVENT_WIFI_STA_GOT_IP) {
    Serial.printf("Wi-Fi connected: http://%s/  (RSSI %d)\n", WiFi.localIP().toString().c_str(), WiFi.RSSI());
    wifiLostAt = 0;
    staUpAt = millis() | 1;
    joinAt = 0;
  } else if (e == ARDUINO_EVENT_WIFI_STA_DISCONNECTED) {
    if (!wifiLostAt) wifiLostAt = millis() | 1;
  }
}

static void startWiFi() {
  WiFi.persistent(true);
  WiFi.setHostname(HOSTNAME);
  WiFi.mode(WIFI_STA);
  WiFi.setTxPower(WIFI_POWER_8_5dBm);   // Super Mini boards connect more reliably at lower power
  WiFi.onEvent(onWiFiEvent);
  WiFi.setSleep(false);                 // lowest latency
  WiFi.setAutoReconnect(true);
  wifi_config_t conf;
  bool saved = esp_wifi_get_config(WIFI_IF_STA, &conf) == ESP_OK && conf.sta.ssid[0] != 0;
  if (strlen(WIFI_SSID)) {
    WiFi.begin(WIFI_SSID, WIFI_PASS);
  } else if (saved) {
    Serial.printf("Joining saved Wi-Fi '%s'\n", (const char*)conf.sta.ssid);
    WiFi.begin();
  } else {
    Serial.println("No Wi-Fi saved");
    startAP();
  }
  wifiLostAt = millis() | 1;
}

static void serviceWiFi() {
  bool up = WiFi.status() == WL_CONNECTED;
  if (up && !mdnsOk) {
    mdnsOk = MDNS.begin(HOSTNAME);
    if (mdnsOk) {
      MDNS.addService("http", "tcp", 80);
      MDNS.addService("solarmon", "tcp", 80);
      MDNS.addServiceTxt("solarmon", "tcp", "fw", FW_VERSION);
      Serial.println("Also at: http://" HOSTNAME ".local/");
    }
  }
  // keep the hotspot 2 minutes after joining so the setup page can show the new address
  if (up && apOn && staUpAt && millis() - staUpAt > 120000 && WiFi.softAPgetStationNum() == 0) stopAP();
  if (up && apOn && staUpAt && millis() - staUpAt > 600000) stopAP();
  if (!up && wifiLostAt && millis() - wifiLostAt > 90000 && !apOn) startAP();   // let the user fix Wi-Fi
}

// ---------- web ----------
static void sendJson(AsyncWebServerRequest* r, const String& s) {
  AsyncWebServerResponse* res = r->beginResponse(200, "application/json", s);
  res->addHeader("Cache-Control", "no-store");
  r->send(res);
}

// Requests that came in over the setup hotspot: only someone standing next to the monitor can send these.
static bool fromHotspot(AsyncWebServerRequest* r) {
  return apOn && r->client() && r->client()->localIP() == WiFi.softAPIP();
}

static bool needAdmin(AsyncWebServerRequest* r) {
  if (r->authenticate(ADMIN_USER, ADMIN_PASS)) return false;
  r->requestAuthentication(AsyncAuthType::AUTH_BASIC);
  return true;
}

static String param(AsyncWebServerRequest* r, const char* name) {
  if (r->hasParam(name, true)) return r->getParam(name, true)->value();
  if (r->hasParam(name)) return r->getParam(name)->value();
  return String();
}

static bool wwwUploadFailed = false;   // uploads are sent one at a time by deploy.mjs

// Only simple relative paths inside /www: "index.html.gz", "favicon.svg", "assets/<name>"
static bool wwwPathOk(const String& p) {
  if (p.isEmpty() || p.length() > 48 || p.indexOf("..") >= 0 || p.startsWith("/")) return false;
  for (size_t i = 0; i < p.length(); i++) {
    char c = p[i];
    if (!(isalnum((unsigned char)c) || c == '.' || c == '-' || c == '_' || c == '/')) return false;
  }
  int slash = p.indexOf('/');
  return slash < 0 ? true : (p.startsWith("assets/") && p.indexOf('/', 7) < 0);
}

static const char UPDATE_PAGE[] PROGMEM = R"HTML(<!doctype html><meta name=viewport content="width=device-width,initial-scale=1">
<title>Firmware update</title><body style="font-family:system-ui;max-width:480px;margin:40px auto;padding:0 16px">
<h2>Firmware update</h2><p>Select the compiled <b>.bin</b> file (Arduino: Sketch &rarr; Export compiled binary).</p>
<form method=POST enctype=multipart/form-data><input type=file name=fw accept=.bin required> <button>Upload</button></form>
<p><a href="/">Back to dashboard</a></p></body>)HTML";

static void setupWeb() {
  DefaultHeaders::Instance().addHeader("Access-Control-Allow-Origin", "*");
  DefaultHeaders::Instance().addHeader("Access-Control-Allow-Headers", "*");

  // Dashboard: the full web app lives in flash (/www, uploaded with web/scripts/deploy.mjs);
  // the small built-in dashboard is the fallback and stays reachable at /classic.
  auto classic = [](AsyncWebServerRequest* r) {
    AsyncWebServerResponse* res = r->beginResponse(200, "text/html", INDEX_HTML_GZ, INDEX_HTML_GZ_LEN);
    res->addHeader("Content-Encoding", "gzip");
    res->addHeader("Cache-Control", "no-cache");
    r->send(res);
  };
  server.on("/classic", HTTP_GET, classic);
  auto setupPage = [](AsyncWebServerRequest* r) {
    AsyncWebServerResponse* res = r->beginResponse(200, "text/html", (const uint8_t*)SETUP_HTML, strlen_P(SETUP_HTML));
    res->addHeader("Cache-Control", "no-store");
    r->send(res);
  };
  server.on("/setup", HTTP_GET, setupPage);
  server.on("/", HTTP_GET, [classic, setupPage](AsyncWebServerRequest* r) {
    if (fromHotspot(r) && WiFi.status() != WL_CONNECTED) { setupPage(r); return; }
    if (fsOk && LittleFS.exists("/www/index.html.gz")) {
      AsyncWebServerResponse* res = r->beginResponse(LittleFS, "/www/index.html.gz", "text/html");
      res->addHeader("Content-Encoding", "gzip");
      res->addHeader("Cache-Control", "no-cache");
      r->send(res);
    } else {
      classic(r);
    }
  });
  // hashed file names never change content, so browsers may cache them for a year
  server.serveStatic("/assets/", LittleFS, "/www/assets/").setCacheControl("public, max-age=31536000, immutable");
  server.serveStatic("/favicon.svg", LittleFS, "/www/favicon.svg").setCacheControl("public, max-age=86400");

  // Web app upload (admin): POST /api/www?path=assets/x.js.gz (multipart file), GET /api/www (list), POST /api/www/delete?path=...
  server.on("/api/www", HTTP_GET, [](AsyncWebServerRequest* r) {
    String s = "[";
    File dir = LittleFS.open("/www/assets");
    bool first = true;
    if (dir) for (File f = dir.openNextFile(); f; f = dir.openNextFile()) {
      if (!first) s += ",";
      s += "\"assets/" + String(f.name()) + "\"";
      first = false;
      f.close();
    }
    for (const char* top : {"index.html.gz", "favicon.svg"}) {
      if (LittleFS.exists(String("/www/") + top)) { if (!first) s += ","; s += String("\"") + top + "\""; first = false; }
    }
    s += "]";
    sendJson(r, s);
  });
  server.on("/api/www/delete", HTTP_POST, [](AsyncWebServerRequest* r) {
    if (needAdmin(r)) return;
    String p = param(r, "path");
    if (!wwwPathOk(p)) { r->send(400, "text/plain", "bad path"); return; }
    bool ok = LittleFS.remove("/www/" + p);
    sendJson(r, ok ? "{\"ok\":true}" : "{\"ok\":false}");
  });
  server.on("/api/www", HTTP_POST,
    [](AsyncWebServerRequest* r) {
      if (!r->authenticate(ADMIN_USER, ADMIN_PASS)) { r->requestAuthentication(AsyncAuthType::AUTH_BASIC); return; }
      bool ok = !wwwUploadFailed;
      sendJson(r, ok ? "{\"ok\":true}" : "{\"ok\":false}");
    },
    [](AsyncWebServerRequest* r, const String& filename, size_t index, uint8_t* data, size_t len, bool final) {
      static File out;
      if (!r->authenticate(ADMIN_USER, ADMIN_PASS)) return;
      String p = param(r, "path");
      if (index == 0) {
        wwwUploadFailed = false;
        if (out) out.close();
        if (!wwwPathOk(p)) { wwwUploadFailed = true; return; }
        if (!LittleFS.exists("/www")) LittleFS.mkdir("/www");
        if (!LittleFS.exists("/www/assets")) LittleFS.mkdir("/www/assets");
        out = LittleFS.open("/www/" + p, "w");
        if (!out) { wwwUploadFailed = true; return; }
      }
      if (out && len && out.write(data, len) != len) { wwwUploadFailed = true; out.close(); }
      if (final && out) out.close();
    });

  events.onConnect([](AsyncEventSourceClient* c) {
    static char out[sizeof(liveJson)];
    lock(); strlcpy(out, liveJson, sizeof(out)); uint32_t id = seq; unlock();
    c->send(out, "live", id, 2000);   // also tells the browser to retry after 2 s if dropped
  });
  server.addHandler(&events);
  statusEvents.onConnect([](AsyncEventSourceClient* c) {
    static char out[sizeof(liveJson)];
    lock(); strlcpy(out, liveJson, sizeof(out)); uint32_t id = seq; unlock();
    c->send(out, "live", id, 5000);
  });
  server.addHandler(&statusEvents);

  auto liveHandler = [](AsyncWebServerRequest* r) {
    lock(); String s(liveJson); unlock();
    sendJson(r, s);
  };
  server.on("/api/live", HTTP_GET, liveHandler);
  server.on("/data", HTTP_GET, liveHandler);   // old endpoint name
  server.on("/api/info", HTTP_GET, [](AsyncWebServerRequest* r) { sendJson(r, buildInfoJson()); });

  server.on("/api/recent", HTTP_GET, [](AsyncWebServerRequest* r) {
    lock();
    int count = ringCount, start = (ringHead - ringCount + RECENT_SAMPLES) % RECENT_SAMPLES;
    unlock();
    size_t len = count * sizeof(Sample);
    AsyncWebServerResponse* res = r->beginResponse("application/octet-stream", len,
      [start, len](uint8_t* buf, size_t maxLen, size_t index) -> size_t {
        size_t n = 0;
        lock();
        while (n < maxLen && index + n < len) {
          size_t pos = index + n, i = pos / sizeof(Sample), off = pos % sizeof(Sample);
          size_t take = min(maxLen - n, sizeof(Sample) - off);
          memcpy(buf + n, (const uint8_t*)&ring[(start + i) % RECENT_SAMPLES] + off, take);
          n += take;
        }
        unlock();
        return n;
      });
    res->addHeader("Cache-Control", "no-store");
    r->send(res);
  });

  server.on("/api/day", HTTP_GET, [](AsyncWebServerRequest* r) {
    uint32_t d = strtoul(param(r, "d").c_str(), nullptr, 10);
    lock(); uint32_t td = today.date; int cnt = todayCount; unlock();
    if (d == 0) d = td;
    if (d == td && td) {
      size_t len = cnt * sizeof(MinRec);
      AsyncWebServerResponse* res = r->beginResponse("application/octet-stream", len,
        [len](uint8_t* buf, size_t maxLen, size_t index) -> size_t {
          size_t n = min(maxLen, len - index);
          lock(); memcpy(buf, (uint8_t*)todayRecs + index, n); unlock();
          return n;
        });
      res->addHeader("Cache-Control", "no-store");
      r->send(res);
      return;
    }
    String p = dayPath(d);
    if (fsOk && LittleFS.exists(p)) {
      AsyncWebServerResponse* res = r->beginResponse(LittleFS, p, "application/octet-stream");
      res->addHeader("Cache-Control", "max-age=60");
      r->send(res);
    } else {
      r->send(404, "text/plain", "no data for that day");
    }
  });

  server.on("/api/days", HTTP_GET, [](AsyncWebServerRequest* r) {
    size_t fileLen = 0;
    if (fsOk) { File f = LittleFS.open("/days.bin", "r"); if (f) { fileLen = f.size() / sizeof(DayRec) * sizeof(DayRec); f.close(); } }
    auto cur = std::make_shared<DayRec>();
    lock(); *cur = today; unlock();
    if (cur->battMin == 255) cur->battMin = 0;
    size_t total = fileLen + (cur->date ? sizeof(DayRec) : 0);
    AsyncWebServerResponse* res = r->beginResponse("application/octet-stream", total,
      [fileLen, cur, total](uint8_t* buf, size_t maxLen, size_t index) -> size_t {
        size_t n = 0;
        if (index < fileLen) {
          File f = LittleFS.open("/days.bin", "r");
          if (f) { f.seek(index); n = f.read(buf, min(maxLen, fileLen - index)); f.close(); }
        } else if (index < total) {
          size_t off = index - fileLen;
          n = min(maxLen, sizeof(DayRec) - off);
          memcpy(buf, (uint8_t*)cur.get() + off, n);
        }
        return n;
      });
    res->addHeader("Cache-Control", "no-store");
    r->send(res);
  });

  server.on("/api/time", HTTP_POST, [](AsyncWebServerRequest* r) {
    double t = param(r, "t").toDouble();
    if (t > 1735689600 && (!timeValid() || timeSetByClient)) {
      struct timeval tv = {(time_t)t, 0};
      settimeofday(&tv, nullptr);
      timeSetByClient = true;
      Serial.println("Clock set by dashboard");
    }
    sendJson(r, String("{\"timeOk\":") + (timeValid() ? "true" : "false") + "}");
  });

  server.on("/api/settings", HTTP_POST, [](AsyncWebServerRequest* r) {
    String v;
    lock();
    if ((v = param(r, "battAh")).length()) { setBattAh = constrain(v.toFloat(), 0, 10000); prefs.putFloat("battAh", setBattAh); }
    if ((v = param(r, "tariff")).length()) { setTariff = constrain(v.toFloat(), 0, 10000); prefs.putFloat("tariff", setTariff); }
    if ((v = param(r, "name")).length())   { setName = v.substring(0, 30); prefs.putString("name", setName); }
    int cd = param(r, "cycDay").toInt(), ch = param(r, "cycHour").length() ? param(r, "cycHour").toInt() : setCycHour;
    if (cd >= 1 && cd <= 28 && ch >= 0 && ch <= 23 && (cd != setCycDay || ch != setCycHour)) {
      setCycDay = cd; setCycHour = ch; cycMoved = true;
      prefs.putInt("cycDay", cd); prefs.putInt("cycHour", ch);
    }
    if ((v = param(r, "tz")).length() && v.length() < 40) {
      setTz = v; prefs.putString("tz", setTz);
      setenv("TZ", setTz.c_str(), 1); tzset();
    }
    unlock();
    sendJson(r, buildInfoJson());
  });

  // Stored as-is so the web and phone apps share one set of tariff rules. Only a quick shape check here:
  // a broken value can only break the bill estimator, which falls back to defaults.
  server.on("/api/bill", HTTP_GET, [](AsyncWebServerRequest* r) {
    lock(); String v = setBill; unlock();
    sendJson(r, v.length() ? v : String("{}"));
  });
  server.on("/api/bill", HTTP_POST, [](AsyncWebServerRequest* r) {
    String v = param(r, "v");
    bool ok = v.length() >= 2 && v.length() <= 2048 && v[0] == '{' && v[v.length() - 1] == '}';
    for (size_t i = 0; ok && i < v.length(); i++) if ((uint8_t)v[i] < 0x20) ok = false;
    if (!ok) { r->send(400, "application/json", "{\"error\":\"bad value\"}"); return; }
    lock(); setBill = v; prefs.putString("bill", setBill); unlock();
    sendJson(r, v);
  });

  server.on("/api/refresh", HTTP_POST, [](AsyncWebServerRequest* r) {
    refreshRated = true;
    sendJson(r, "{\"ok\":true}");
  });

  server.on("/api/scan", HTTP_GET, [](AsyncWebServerRequest* r) {
    int n = WiFi.scanComplete();
    if (n == WIFI_SCAN_FAILED) { WiFi.scanNetworks(true); sendJson(r, "{\"scanning\":true}"); return; }
    if (n == WIFI_SCAN_RUNNING) { sendJson(r, "{\"scanning\":true}"); return; }
    String s = "{\"scanning\":false,\"nets\":[";
    for (int i = 0; i < n; i++) {
      char ssid[40];
      jsonSafe(ssid, WiFi.SSID(i).c_str(), sizeof(ssid));
      if (i) s += ",";
      s += "{\"ssid\":\"" + String(ssid) + "\",\"rssi\":" + WiFi.RSSI(i) + ",\"open\":" +
           (WiFi.encryptionType(i) == WIFI_AUTH_OPEN ? "true" : "false") + "}";
    }
    s += "]}";
    WiFi.scanDelete();
    sendJson(r, s);
  });

  server.on("/api/wifistatus", HTTP_GET, [](AsyncWebServerRequest* r) {
    char ssid[40];
    jsonSafe(ssid, WiFi.SSID().c_str(), sizeof(ssid));
    bool up = WiFi.status() == WL_CONNECTED;
    bool failed = !up && joinAt && millis() - joinAt > 30000;
    sendJson(r, String("{\"connected\":") + (up ? "true" : "false") + ",\"failed\":" + (failed ? "true" : "false") +
      ",\"ip\":\"" + WiFi.localIP().toString() + "\",\"host\":\"" HOSTNAME "\",\"ssid\":\"" + ssid + "\",\"ap\":\"" + apName + "\"}");
  });

  // From the setup hotspot no password is needed (first-time setup); from the home network it needs the admin password.
  server.on("/api/wifi", HTTP_POST, [](AsyncWebServerRequest* r) {
    if (!fromHotspot(r) && needAdmin(r)) return;
    String ssid = param(r, "ssid"), pass = param(r, "pass");
    if (!ssid.length()) { r->send(400, "text/plain", "ssid missing"); return; }
    sendJson(r, "{\"ok\":true,\"msg\":\"Joining network. Reconnect to the dashboard on the new network.\"}");
    WiFi.begin(ssid.c_str(), pass.c_str());
    wifiLostAt = millis() | 1;
    joinAt = millis() | 1;
    staUpAt = 0;
  });

  // ---- inverter settings (password SET_PASS). The change itself runs in the loop task, the app polls the job. ----
  auto setPassOk = [](AsyncWebServerRequest* r) -> bool {
    if (param(r, "pw") == SET_PASS) return true;
    r->send(401, "application/json", "{\"error\":\"wrong password\"}");   // no WWW-Authenticate: no browser pop-up
    return false;
  };
  server.on("/api/inv/auth", HTTP_POST, [setPassOk](AsyncWebServerRequest* r) {
    if (setPassOk(r)) sendJson(r, "{\"ok\":true}");
  });
  server.on("/api/inv/set", HTTP_POST, [setPassOk](AsyncWebServerRequest* r) {
    if (!setPassOk(r)) return;
    String key = param(r, "key"), val = param(r, "value"), letter = param(r, "letter"), by = param(r, "by");
    char err[64], cmd[24], q[160], cl[64], al[64];
    lock(); strlcpy(q, qpiri, sizeof q); strlcpy(cl, chgCur, sizeof cl); strlcpy(al, acCur, sizeof al); bool busy = setJob.state == 1; unlock();
    if (busy) { r->send(409, "application/json", "{\"error\":\"another change is still running\"}"); return; }
    // checked here too so the app gets the reason at once; checked again just before sending
    if (!val.length() || !buildSetCommand(key.c_str(), val.toFloat(), letter.length() ? letter[0] : 0, q, cl, al, cmd, sizeof cmd, err, sizeof err)) {
      char b[120]; snprintf(b, sizeof b, "{\"error\":\"%s\"}", val.length() ? err : "value missing");
      r->send(400, "application/json", b);
      return;
    }
    char who[40], safeBy[20];
    jsonSafe(safeBy, by.c_str(), sizeof safeBy);
    snprintf(who, sizeof who, "%s %s", safeBy, r->client() ? r->client()->remoteIP().toString().c_str() : "");
    lock();
    setJob.id++;
    strlcpy(setJob.key, key.c_str(), sizeof setJob.key);
    setJob.value = val.toFloat();
    setJob.letter = letter.length() ? letter[0] : 0;
    strlcpy(setJob.by, who, sizeof setJob.by);
    setJob.msg[0] = 0;
    setJob.state = 1;
    uint32_t id = setJob.id;
    unlock();
    sendJson(r, String("{\"id\":") + id + "}");
  });
  server.on("/api/inv/job", HTTP_GET, [](AsyncWebServerRequest* r) {
    static const char* names[] = {"none", "waiting", "ok", "failed"};
    char b[200], m[96];
    lock(); jsonSafe(m, setJob.msg, sizeof m); snprintf(b, sizeof b, "{\"id\":%lu,\"state\":\"%s\",\"msg\":\"%s\"}", (unsigned long)setJob.id, names[setJob.state], m); unlock();
    sendJson(r, b);
  });
  server.on("/api/inv/log", HTTP_GET, [](AsyncWebServerRequest* r) {
    String s = "[";
    File f = fsOk ? LittleFS.open("/setlog.txt", "r") : File();
    if (f) {
      bool first = true;
      while (f.available()) {
        String line = f.readStringUntil('\n');
        line.trim();
        if (!line.startsWith("{")) continue;
        if (!first) s += ",";
        s += line; first = false;
      }
      f.close();
    }
    s += "]";
    sendJson(r, s);
  });
  server.on("/api/probe", HTTP_POST, [setPassOk](AsyncWebServerRequest* r) {
    if (!setPassOk(r)) return;
    lock(); if (probeState != 1) { probeState = 1; probeText = ""; } unlock();
    sendJson(r, "{\"ok\":true}");
  });
  server.on("/api/probe", HTTP_GET, [](AsyncWebServerRequest* r) {
    lock(); String s = String(probeState == 1 ? "state: running\n" : probeState == 2 ? "state: done\n" : "state: never run\n") + probeText; unlock();
    r->send(200, "text/plain", s);
  });

  server.on("/raw", HTTP_GET, [](AsyncWebServerRequest* r) {
    char b[600];
    lock();
    snprintf(b, sizeof(b), "Protocol: %s\nQPIRI: %s\nQID: %s\nQVFW: %s\nQFLAG: %s\nQMCHGCR: %s\nQMUCHGCR: %s\nQBEQI: %s\nlast error: %s\n",
             protoName(invProto), qpiri, qid, qvfw, qflag, chgCur, acCur, qbeqi, invErr);
    unlock();
    r->send(200, "text/plain", b);
  });

  // firmware update
  server.on("/update", HTTP_GET, [](AsyncWebServerRequest* r) {
    if (needAdmin(r)) return;
    r->send(200, "text/html", UPDATE_PAGE);
  });
  server.on("/update", HTTP_POST,
    [](AsyncWebServerRequest* r) {
      if (!r->authenticate(ADMIN_USER, ADMIN_PASS)) { r->requestAuthentication(AsyncAuthType::AUTH_BASIC); return; }
      bool ok = !Update.hasError();
      r->send(ok ? 200 : 500, "text/plain", ok ? "Update OK, restarting...\n" : (String("Update failed: ") + Update.errorString() + "\n"));
      if (ok) { rebootAt = millis() + 1500; rebootPending = true; }
    },
    [](AsyncWebServerRequest* r, const String& filename, size_t index, uint8_t* data, size_t len, bool final) {
      if (!r->authenticate(ADMIN_USER, ADMIN_PASS)) return;
      if (index == 0) {
        Serial.printf("OTA start: %s\n", filename.c_str());
        Update.begin(UPDATE_SIZE_UNKNOWN, U_FLASH);
      }
      if (len && !Update.hasError()) Update.write(data, len);
      if (final) {
        if (Update.end(true)) Serial.printf("OTA done: %u bytes\n", (unsigned)(index + len));
        else Serial.printf("OTA failed: %s\n", Update.errorString());
      }
    });

  server.onNotFound([](AsyncWebServerRequest* r) {
    if (r->method() == HTTP_OPTIONS) { r->send(204); return; }
    if (fromHotspot(r)) { r->redirect("http://" + WiFi.softAPIP().toString() + "/setup"); return; }   // phones' "sign in to network" check
    r->send(404, "text/plain", "Not found");
  });
  server.begin();
}

// ---------- setup / loop ----------
void setup() {
  Serial.begin(115200);
  if (LED_PIN >= 0) pinMode(LED_PIN, OUTPUT);
  ledSet(false);
  dataMux = xSemaphoreCreateMutex();
  Serial1.setRxBufferSize(512);
  Serial1.begin(2400, SERIAL_8N1, INV_RX_PIN, INV_TX_PIN);
  delay(200);
  Serial.println("\nSolar Monitor v" FW_VERSION);

  prefs.begin("solar", false);
  setBattAh = prefs.getFloat("battAh", 0);
  setTariff = prefs.getFloat("tariff", 0);
  setName = prefs.getString("name", "Solar");
  setTz = prefs.getString("tz", TZ_DEFAULT);
  setBill = prefs.getString("bill", "");
  setCycDay = prefs.getInt("cycDay", 0);
  setCycHour = prefs.getInt("cycHour", 20);
  if (prefs.getBytesLength("cyc") == sizeof(Cycle)) prefs.getBytes("cyc", &cyc, sizeof(cyc));

  fsOk = LittleFS.begin(true);   // formats the data partition on first run
  Serial.printf("Storage: %s, %u / %u bytes used\n", fsOk ? "ok" : "FAILED",
                fsOk ? (unsigned)LittleFS.usedBytes() : 0, fsOk ? (unsigned)LittleFS.totalBytes() : 0);
  if (fsOk && !LittleFS.exists("/h")) LittleFS.mkdir("/h");

  dayInit(today, 0);
  startWiFi();
  configTzTime(setTz.c_str(), "pool.ntp.org", "time.google.com", "time.cloudflare.com");
  setupWeb();

  // watchdog: restart if the main loop ever hangs for 30 s (a full inverter cycle takes under 8 s)
  esp_task_wdt_config_t wdt = {.timeout_ms = 30000, .idle_core_mask = 0, .trigger_panic = true};
  if (esp_task_wdt_reconfigure(&wdt) != ESP_OK) esp_task_wdt_init(&wdt);
  esp_task_wdt_add(nullptr);
  pinMode(BOOT_BTN_PIN, INPUT_PULLUP);
}

// Hold the BOOT button for 5 s: forget the Wi-Fi and open the setup hotspot (moving house, new router).
static void serviceButton() {
  static uint32_t downAt = 0;
  if (digitalRead(BOOT_BTN_PIN) == LOW) {
    if (!downAt) downAt = millis() | 1;
    else if (millis() - downAt > 5000) {
      downAt = 0;
      Serial.println("Button: forgetting Wi-Fi, opening setup hotspot");
      WiFi.disconnect(false, true);
      staUpAt = 0;
      startAP();
      for (int i = 0; i < 6; i++) { ledSet(i & 1); delay(120); }
    }
  } else downAt = 0;
}

// Last-resort recovery: a restart fixes a stuck Wi-Fi stack or a memory leak. Readings are saved every minute.
static void serviceHealth() {
  bool wifiStuck = wifiLostAt && millis() - wifiLostAt > 20UL * 60000 && (!apOn || WiFi.softAPgetStationNum() == 0) && WiFi.SSID().length();
  // low memory only counts if it lasts 30 s (uploads dip it for a moment)
  static uint32_t lowSince = 0;
  if (ESP.getFreeHeap() < 10000) { if (!lowSince) lowSince = millis() | 1; } else lowSince = 0;
  bool lowMem = lowSince && millis() - lowSince > 30000;
  if ((wifiStuck || lowMem) && !rebootPending) {
    Serial.printf("Health: restarting (%s)\n", lowMem ? "low memory" : "Wi-Fi lost for 20 min");
    rebootPending = true;
    rebootAt = millis() + 500;
  }
}

void loop() {
  static uint32_t lastCycle = 0;
  if (millis() - lastCycle >= MIN_CYCLE_MS) {
    lastCycle = millis();
    pollInverter();
  }
  serviceWiFi();
  serviceButton();
  serviceTrial();
  serviceHealth();
  if (apOn) dns.processNextRequest();
  if (cyc.start && millis() - cycSavedMs > 15UL * 60000) saveCycle();
  esp_task_wdt_reset();
  if (rebootPending && (int32_t)(millis() - rebootAt) > 0) {
    finalizeMinute();
    if (cyc.start) saveCycle();
    ESP.restart();
  }
  delay(2);
}
