sharjeelmazhar/solar-monitor/(commit log)

2026-10-07 Stage 0: monorepo, protocol tests, secret scanning and CI
    - One repo: firmware/ (v3 sketch, embedded dashboard, legacy sketches, tools),
    android/ (moved from AndroidStudioProjects), docs/, scripts/
    - PI30 protocol split into Arduino-free pi30.h with 85 host-side checks
    (published CRC vectors, malformed/partial/NAK frames, clamps, grid estimate)
    - Passwords moved to git-ignored secrets.h; private photos, captures and the
    flash backup stay out of git; gitleaks rules for LAN IPs and serials
    - Android: JUnit tests for parsing/formatting; default host is solar.local
    with automatic mDNS discovery when the address stops working
    - Pre-commit hook (gitleaks + tests) and GitHub Actions CI
    - do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
2026-10-07 Add GitHub Actions CI: secret scan, firmware tests + ESP32 build, Android tests + build
2026-10-07 New web dashboard served from the ESP32
    - web/: React + Vite + TypeScript app with Tailwind, Base UI and Motion;
    pages Live, History, Energy, Outages, System; light/dark theme
    - Energy-flow hero: particles move in the real power direction, speed and
    line width scale with watts, 15 W dead-band, animated solar/grid/battery/
    home/inverter icons; optional lazy-loaded three.js energy core that pauses
    off-screen and stays off with reduced motion
    - Outage log derived from per-minute grid flags (midnight, data gaps,
    flicker merge), hour-of-day heat map and multi-day timeline
    - Charts: responsive SVG, clamped tooltips, toggle legends, full-screen view
    - Firmware 3.1.0: serves the app from L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
2026-10-07 Outage clock, IESCO bill estimate, offline state, 12-hour time (web + Android)
    - Firmware 3.2.0: GET/POST /api/bill stores the shared bill settings
    - Outages: 24-hour day clock (what powered each hour, grid on/off ring), clearer
    event cards with energy and battery during each outage; new Outages tab in the app
    - Energy: IESCO home bill estimate (NEPRA S.R.O. 279(I)/2026 slabs, protected
    status, fixed charges, FPA/QTA, duty, GST, PTV), daily units table
    - Bill logic shared by web and Android, checked against shared/bill-vectors.json
    - Monitor offline: flow stops, greys out and says when the last reading came
    - 12-hour clock by default, 24-hour option in settings
    - Android 1.1
2026-10-07 Real-bill calculator, unit alerts, one smart notification, floating bar, 3D core (web + Android 1.2)
    - Bill estimate checked against two real IESCO bills (Feb and Sep 2026, within Rs 2): F.C. surcharge,
    FPA on units two bills back, QTA, duty without the fixed charge, GST incl. duty; no TV fee
    - Your bills: history entry, protected status from the last 6 bills, chart and plain-language insights;
    estimate falls back to recent bills while the monitor has under a week of data
    - Unit alerts at 150 / 175 / 190 and when the month is heading over 200
    - "Solar + Grid" style labels, small battery flows shown as idle (setting), daytime weak-solar warning
    - Android: single ongoing notification (aler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
2026-10-07 v1.2.2: sunrise/sunset, no cloudy alert near sunset, battery amps (web + Android)
2026-10-07 Firmware 3.3.1: runs on ESP32-C3, classic ESP32 DevKit and ESP32-S3 (pins per board); new firmware is kept only after it reaches Wi-Fi, else the board rolls back
2026-10-07 Outages: clock details box has a fixed height so hovering never moves the clock; pin the clock only on tall screens
2026-10-08 Firmware 3.4.0 + apps: inverter settings edit mode, protocol auto-detect, GPU 3D core, sliding tab bar
    - Firmware: driver layer that detects PI30 / PI18 by itself (and again after the inverter goes silent), read-only
    probe (PI30, PI18, Modbus fn 03/04) to learn new inverter brands, settings changes behind a settings password
    (secrets.h) with range checks against the battery voltage, ACK + read-back verification and a change log on flash
    - Web + Android: identical Inverter settings card with edit mode (password, 10 min), old -> new confirm, result,
    change log and probe dialog; same ranges as the firmware
    - Android: 3D energy core now OpenGL ES 2.0 on a TextureView (same scene as three.j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
2026-10-08 Android matches the web app screen for screen (v1.4.0)
    - Same fonts (Geist / Geist Mono, bundled), same colour tokens in light and dark (wallpaper colours off)
    - Header: sun logo + live monitor clock; card headers with the web's subtitles; tiles with colour glow and
    numbers that glide to new values; web-style segmented controls with a sliding spring pill
    - Live: Energy flow wording, battery watts on the flow, Right now / Today / Live power as on the web, full-screen charts
    - History: day bar with CSV, chart subtitles, outage list under Grid availability, Day totals with colour dots
    - Energy: month and self-powered cards, Custom range, stacked day/month bars, Totals and Daily units as on th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
2026-10-08 Firmware 3.5.0 + apps 1.5.0: every WatchPower setting (battery type, output V/Hz, equalization, solar feed to grid, restore defaults with typed confirm); glassier Android tab bar
    - Firmware reads QBEQI and checks the new commands against fixed ranges (equalization 5-900 min, 0-90 days,
    12-15.25 V per 12 V); restore needs a confirm code; 178 host tests pass
    - Web and Android show the same rows, an Equalization section and a Restore button that needs RESET typed
    - Audit doc: every WatchPower Parameter Setting screen, opened read-only on the phone
    [config.h, invset.h, solar_monitor_v3.ino]
2026-10-08 Firmware 3.5.1 + apps 1.5.2: Galaxy Envy 9000 support (NUL-padded replies, two solar inputs PV1/PV2), battery-less inverters hide battery tiles and battery warnings
2026-10-08 Apps 1.5.4: flow lines stop at the circle edges; solar fades at night, grid fades when off (line included); glassier tab bar edge; time-first header clock and short status pill so narrow phones keep 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
2026-10-09 Web 1.6.0: cosmos 3D redesign - full-screen WebGL universe behind the app (live sun whose glow and energy stream follow solar output, earth with day/night and city lights, spiral galaxy, starfield), 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
2026-10-09 Web 1.6.0: no false rain badge (rain only when rain is actually falling under a heavy sky; Open-Meteo flags thunder/drizzle codes with 0 mm), moon orbiting the earth, 3D universe on by default (new p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
2026-10-09 Web 1.6.0: night scene (big moonlit moon, earth's dark side with city lights in front of a dimmed sun, moonlit sky, silver figure, sunrise time), real earth from NASA Blue Marble + night-lights maps 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
2026-10-09 Web 1.6.0: cloud badge from the panels (sun up, solar under 50 W averaged over a minute on a 300 W+ system, even when the weather service says clear); 3D robustness (error boundary, WebGL2-only cache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
2026-10-09 Web 1.6.0: review round 2 - even-speed orbit flight past the earth (no hairpin; speed/accel-limited spring, 0 frame jumps), tab swing spring, light theme (no black night sides, luminous sun with warm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
2026-10-09 Web 1.6.0: instant loading screen (no blank page while the monitor serves the app slowly), Live-only first download (other tabs lazy, fetched after the 3D), 3D download failure shows the painted sky 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
2026-10-09 Docs: wiring guide for the ESP32-S3 board (same MAX3232 and 3 RJ45 wires; GPIO 18/17; pins to avoid; RS485 later)
2026-10-09 Docs: colour S3 wiring guide (PDF + pictures): RS232 today, RS485 module and RJ45 breakout for other brands; reserve RS485 pins 4/5/6 on the S3
